Y2K-x/gb-breakout/README.md

# gb-breakout
A Game Boy breakout board for CMOS-level devices

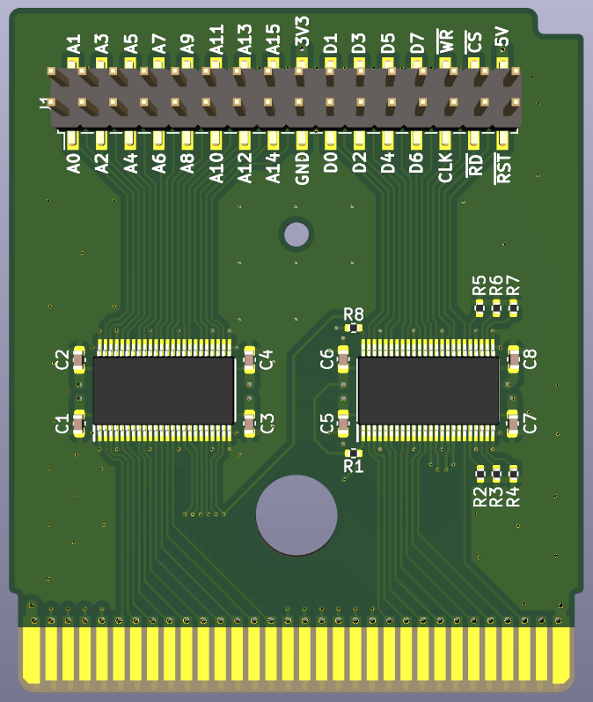
[picture p1: img/render_front.png]
Front

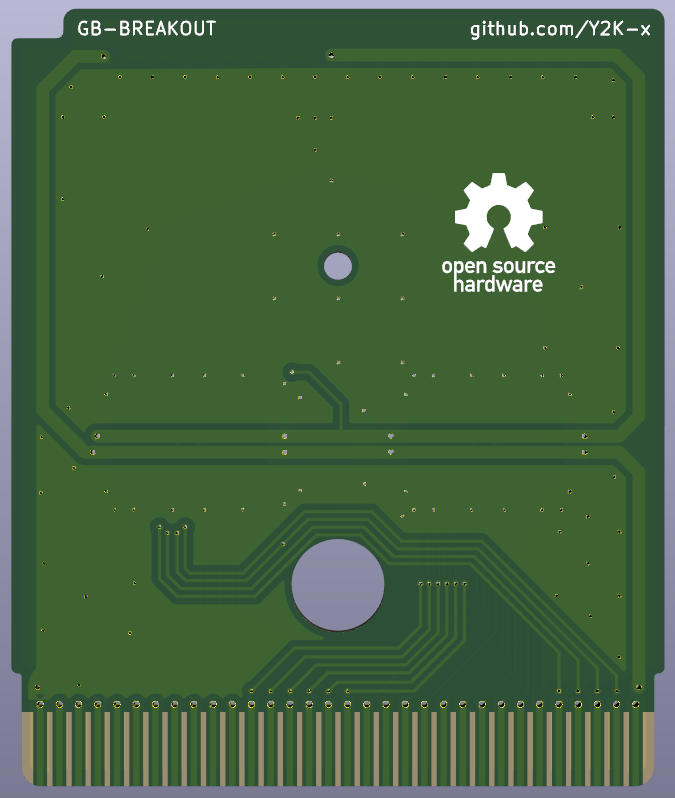
[picture p2: img/render_back.png]
Back
