Y2K-x/gb-breakout/gb_breakout.kicad_pcb

## KiCad design gb_breakout.kicad_pcb (2023-05-16)

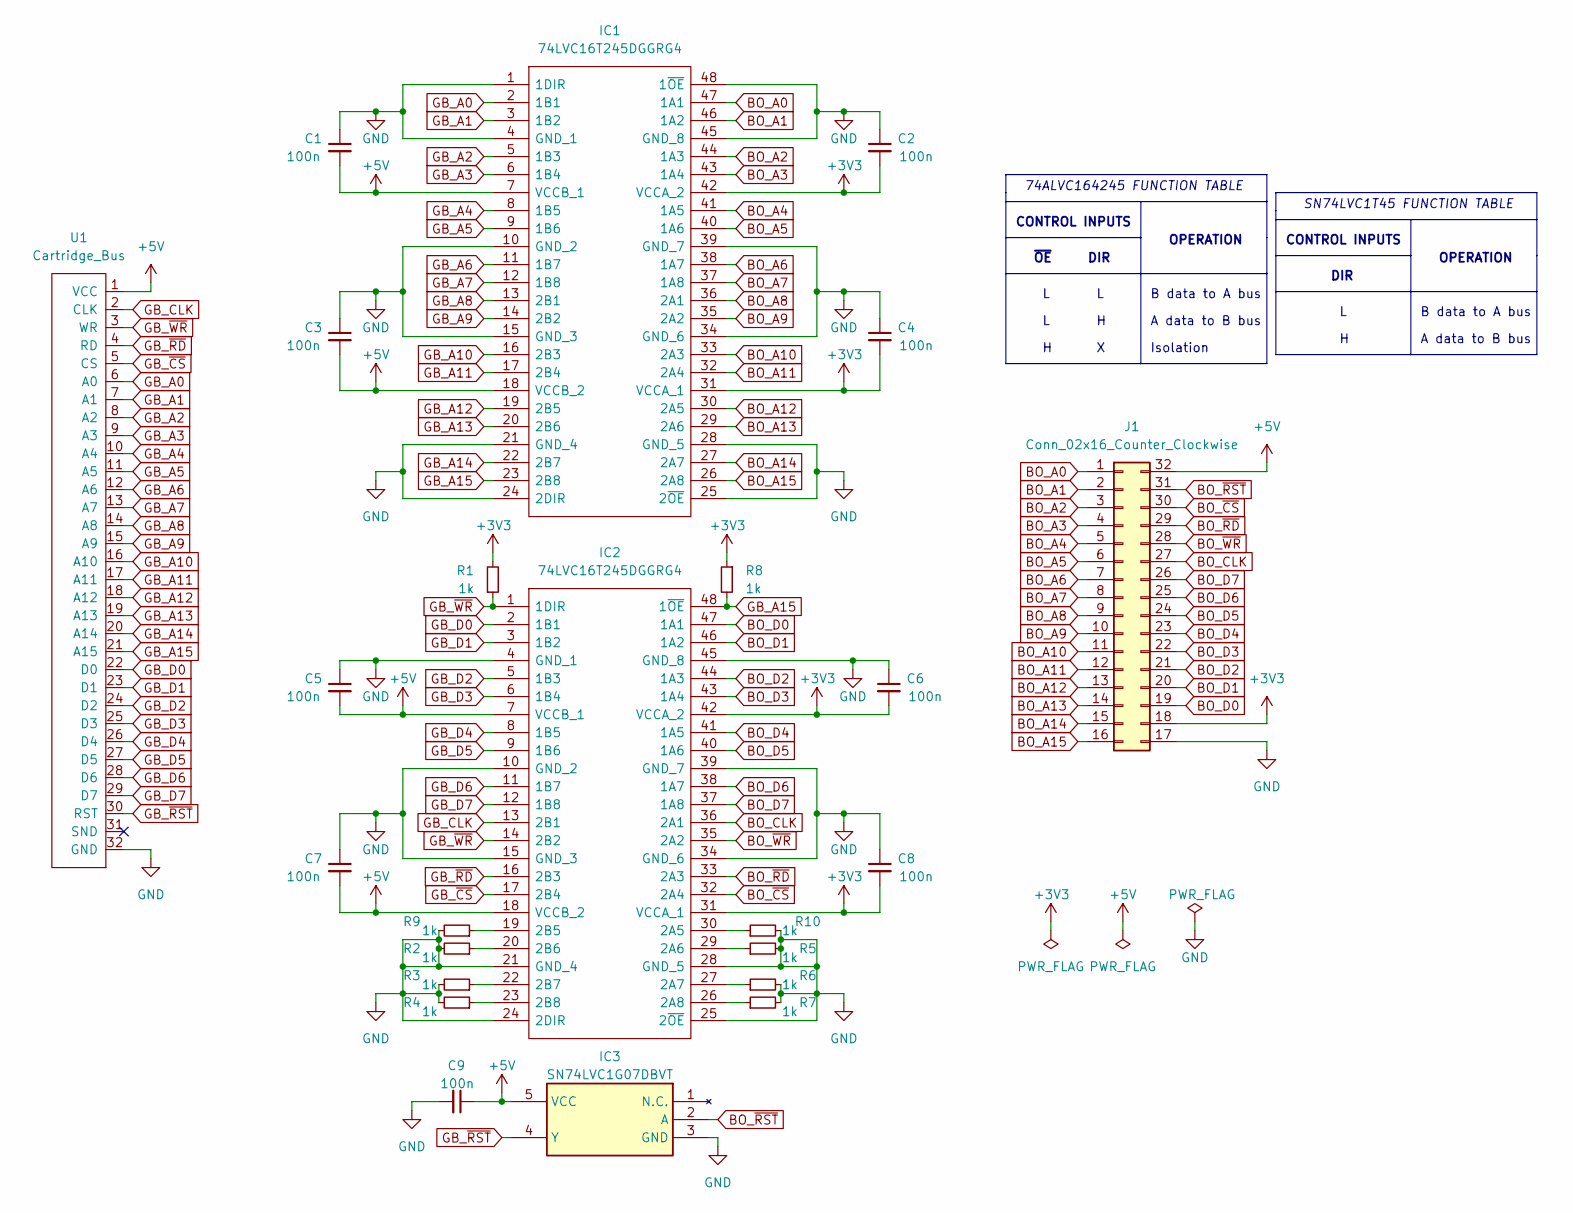
[picture p3: schematic gb_breakout.kicad_sch]

Parts:
C1, C2, C3, C4, C5, C6, C7, C8, C9: 100n; C_0603_1608Metric
IC1, IC2: 74LVC16T245DGGRG4; SOP50P810X120-48N; Mouser Part Number 595-4LVC16T245DGGRG4
IC3: SN74LVC1G07DBVT; SOT95P280X145-5N; Mouser Part Number 595-SN74LVC1G07DBVT
J1: Conn_02x16_Counter_Clockwise; PinHeader_2x16_P2.54mm_Vertical_SMD
R1, R2, R3, R4, R5, R6, R7, R8, R9, R10: 1k; R_0402_1005Metric
U1: Cartridge_Bus; GB_Cartridge

Connections:
+3V3: C2.2, C4.2, C6.2, C8.2, IC1.31 (VCCA_1), IC1.42 (VCCA_2), IC2.31 (VCCA_1), IC2.42 (VCCA_2), J1.18, R1.2, R8.1
+5V: C1.2, C3.2, C5.2, C7.2, C9.1, IC1.7 (VCCB_1), IC1.18 (VCCB_2), IC2.7 (VCCB_1), IC2.18 (VCCB_2), IC3.5 (VCC), J1.32, U1.1 (VCC)
BO_A0: IC1.47 (1A1), J1.1
BO_A1: IC1.46 (1A2), J1.2
BO_A2: IC1.44 (1A3), J1.3
BO_A3: IC1.43 (1A4), J1.4
BO_A4: IC1.41 (1A5), J1.5
BO_A5: IC1.40 (1A6), J1.6
BO_A6: IC1.38 (1A7), J1.7
BO_A7: IC1.37 (1A8), J1.8
BO_A8: IC1.36 (2A1), J1.9
BO_A9: IC1.35 (2A2), J1.10
BO_A10: IC1.33 (2A3), J1.11
BO_A11: IC1.32 (2A4), J1.12
BO_A12: IC1.30 (2A5), J1.13
BO_A13: IC1.29 (2A6), J1.14
BO_A14: IC1.27 (2A7), J1.15
BO_A15: IC1.26 (2A8), J1.16
BO_CLK: IC2.36 (2A1), J1.27
BO_D0: IC2.47 (1A1), J1.19
BO_D1: IC2.46 (1A2), J1.20
BO_D2: IC2.44 (1A3), J1.21
BO_D3: IC2.43 (1A4), J1.22
BO_D4: IC2.41 (1A5), J1.23
BO_D5: IC2.40 (1A6), J1.24
BO_D6: IC2.38 (1A7), J1.25
BO_D7: IC2.37 (1A8), J1.26
BO_~CS: IC2.32 (2A4), J1.30
BO_~RD: IC2.33 (2A3), J1.29
BO_~RST: IC3.2 (A), J1.31
BO_~WR: IC2.35 (2A2), J1.28
GB_A0: IC1.2 (1B1), U1.6 (A0)
GB_A1: IC1.3 (1B2), U1.7 (A1)
GB_A2: IC1.5 (1B3), U1.8 (A2)
GB_A3: IC1.6 (1B4), U1.9 (A3)
GB_A4: IC1.8 (1B5), U1.10 (A4)
GB_A5: IC1.9 (1B6), U1.11 (A5)
GB_A6: IC1.11 (1B7), U1.12 (A6)
GB_A7: IC1.12 (1B8), U1.13 (A7)
GB_A8: IC1.13 (2B1), U1.14 (A8)
GB_A9: IC1.14 (2B2), U1.15 (A9)
GB_A10: IC1.16 (2B3), U1.16 (A10)
GB_A11: IC1.17 (2B4), U1.17 (A11)
GB_A12: IC1.19 (2B5), U1.18 (A12)
GB_A13: IC1.20 (2B6), U1.19 (A13)
GB_A14: IC1.22 (2B7), U1.20 (A14)
GB_A15: IC1.23 (2B8), IC2.48 (1~OE), R8.2, U1.21 (A15)
GB_CLK: IC2.13 (2B1), U1.2 (CLK~)
GB_D0: IC2.2 (1B1), U1.22 (D0)
GB_D1: IC2.3 (1B2), U1.23 (D1)
GB_D2: IC2.5 (1B3), U1.24 (D2)
GB_D3: IC2.6 (1B4), U1.25 (D3)
GB_D4: IC2.8 (1B5), U1.26 (D4)
GB_D5: IC2.9 (1B6), U1.27 (D5)
GB_D6: IC2.11 (1B7), U1.28 (D6)
GB_D7: IC2.12 (1B8), U1.29 (D7)
GB_~CS: IC2.17 (2B4), U1.5 (CS)
GB_~RD: IC2.16 (2B3), U1.4 (RD)
GB_~RST: IC3.4 (Y), U1.30 (RST)
GB_~WR: IC2.1 (1DIR), IC2.14 (2B2), R1.1, U1.3 (WR)
GND: C1.1, C2.1, C3.1, C4.1, C5.1, C6.1, C7.1, C8.1, C9.2, IC1.1 (1DIR), IC1.4 (GND_1), IC1.10 (GND_2), IC1.15 (GND_3), IC1.21 (GND_4), IC1.24 (2DIR), IC1.25 (2~OE), IC1.28 (GND_5), IC1.34 (GND_6), IC1.39 (GND_7), IC1.45 (GND_8), IC1.48 (1~OE), IC2.4 (GND_1), IC2.10 (GND_2), IC2.15 (GND_3), IC2.21 (GND_4), IC2.24 (2DIR), IC2.25 (2~OE), IC2.28 (GND_5), IC2.34 (GND_6), IC2.39 (GND_7), IC2.45 (GND_8), IC3.3 (GND), J1.17, R2.2, R3.2, R4.2, R5.2, R6.2, R7.2, R9.2, R10.2, U1.32 (GND)
unnamed: IC2.30 (2A5), R10.1
unnamed: IC2.29 (2A6), R5.1
unnamed: IC2.27 (2A7), R6.1
unnamed: IC2.26 (2A8), R7.1
unnamed: IC2.19 (2B5), R9.1
unnamed: IC2.20 (2B6), R2.1
unnamed: IC2.22 (2B7), R3.1
unnamed: IC2.23 (2B8), R4.1

Notes on the sheet:
DIR
B data to A bus
CONTROL INPUTS
OPERATION
Isolation
A data to B bus
74ALVC164245 FUNCTION TABLE
SN74LVC1T45 FUNCTION TABLE
~{OE}

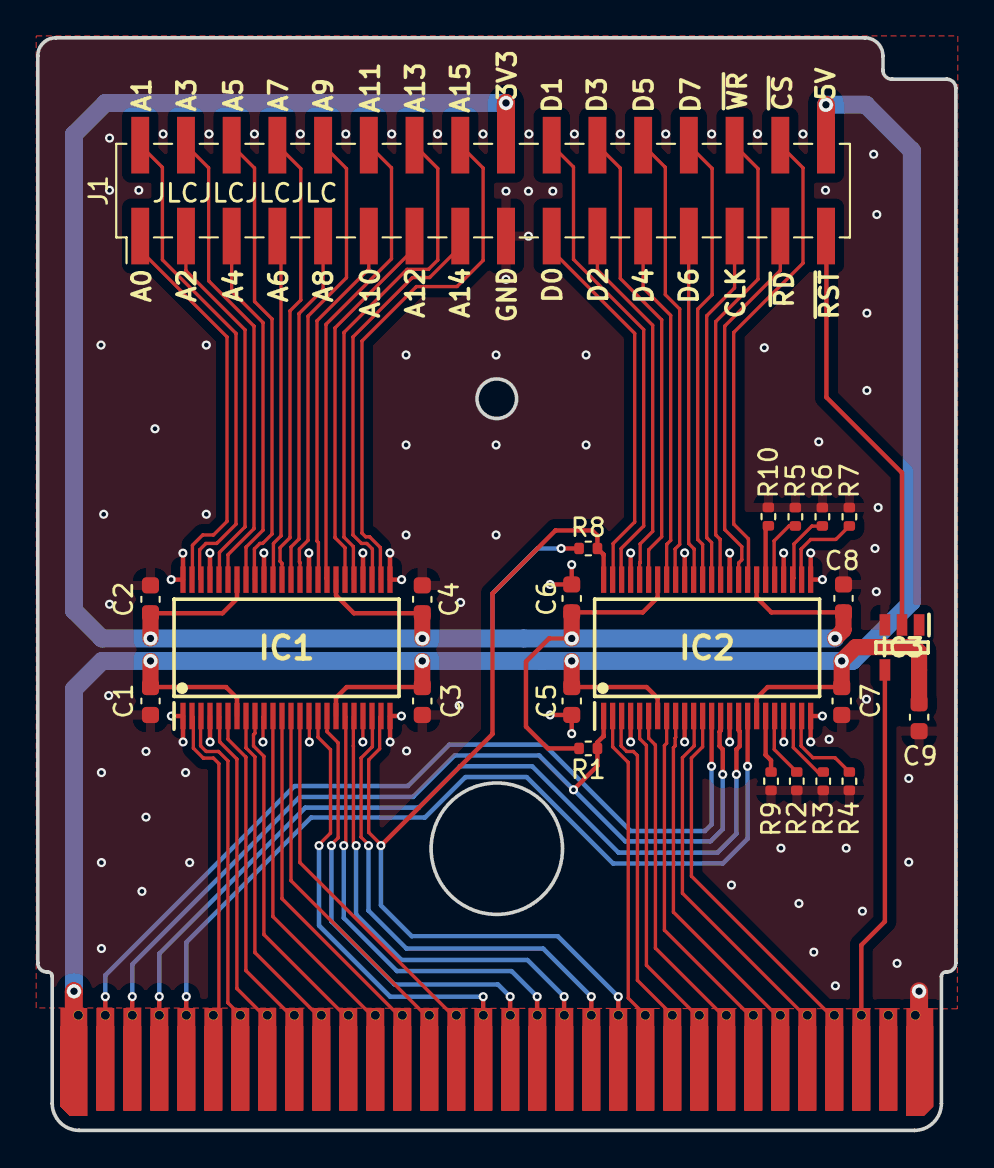
[picture p4: board gb_breakout.kicad_pcb from above]

Board: 2 copper layers, 51.0 x 60.7 mm, 24 parts (0 on the bottom side), 69 nets.
