Y2K-x/gb-breakout/(commit log)

2022-12-20 add initial files + submodules
    [gb_breakout.kicad_pcb, gb_breakout.kicad_sch]
2022-12-20 add libs + fix associations
    [gb_breakout.kicad_pcb, gb_breakout.kicad_sch]
2022-12-20 finished power+gnd routing
    [gb_breakout.kicad_pcb, gb_breakout.kicad_sch]
2022-12-20 removed floating traces that were hidden under other traces + vias
    [gb_breakout.kicad_pcb]
2022-12-20 begin routing address lines
    [gb_breakout.kicad_pcb]
2022-12-20 switched to 74ALVC164245 for level shifting
    [gb_breakout.kicad_pcb, gb_breakout.kicad_sch]
2022-12-20 update gb kicad lib to latest commit
2022-12-20 finish routing address lines, start routing data lines
    [gb_breakout.kicad_pcb, gb_breakout.kicad_sch]
2022-12-20 switch decoupling caps to imperial 0603
    [gb_breakout.kicad_pcb, gb_breakout.kicad_sch]
2022-12-21 finish cart edge routing to bus transcievers
    [gb_breakout.kicad_pcb]
2022-12-21 fix pin header pinout to make better sense to route
    [gb_breakout.kicad_pcb, gb_breakout.kicad_sch]
2022-12-21 PCB done
    [gb_breakout.kicad_pcb]
2022-12-21 update gitignore to ignore gerbers
2022-12-21 change 0201 resistor to 0402, woops
    [gb_breakout.kicad_pcb, gb_breakout.kicad_sch]
2022-12-21 add BOM
    [gb_breakout.csv]
2022-12-21 add pulldown resistors to floating transciever pins, update render, update BOM
    [gb_breakout.csv, gb_breakout.kicad_pcb, gb_breakout.kicad_sch]
2022-12-28 replace bus transciever with SN74LVC16T245 to remove power sequencing requirement
    [gb_breakout.kicad_pcb, gb_breakout.kicad_sch]
2022-12-28 update BOM
    [gb_breakout.csv]
2022-12-28 OE on 2nd bus transciever now connected to A15, isolates data bus from the cartridge when GB is not accessing the cartridge specifically (ROM reads only at the moment)
    [gb_breakout.kicad_pcb, gb_breakout.kicad_sch]
2022-12-29 update BOM with digikey links instead, cheaper BOM price
    [gb_breakout.csv]
2023-05-11 fixed reset line direction in schematic by adding a dedicated bus transciever
    [gb_breakout.kicad_sch]
2023-05-11 disconnect reset signal from IC2
    [gb_breakout.kicad_sch]
2023-05-16 remove SN74LVC1T45 library & references since it's not what I need
    [gb_breakout.kicad_pcb, gb_breakout.kicad_sch]
2023-05-16 add open drain buffer to reset line
    [gb_breakout.kicad_sch]
2023-05-16 route open drain buffer on PCB
    [gb_breakout.kicad_pcb, gb_breakout.kicad_sch]
